spark404/STM32F070-board/ToyDevice.kicad_pcb

## KiCad design ToyDevice.kicad_pcb (2023-11-18)

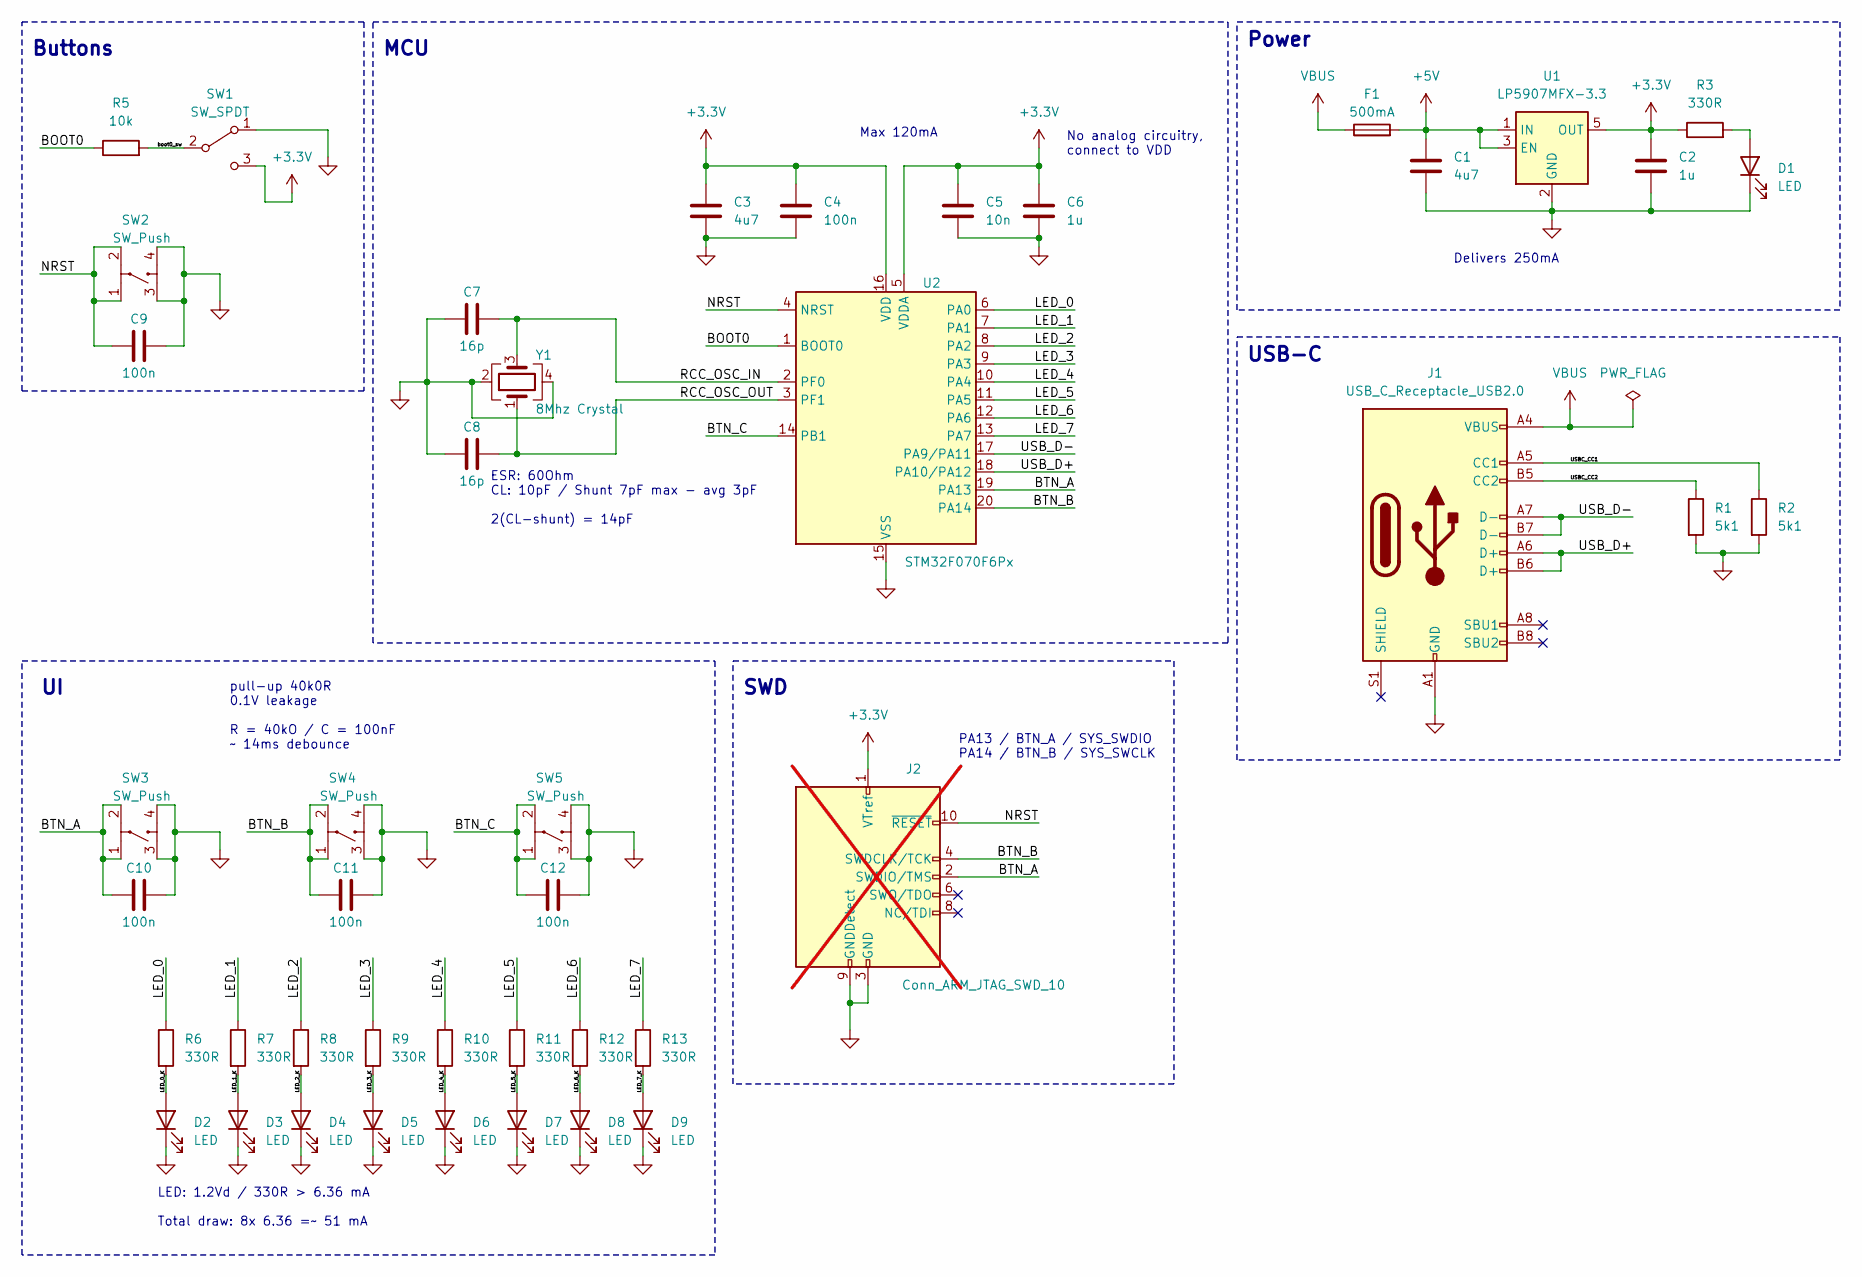
[picture p1: schematic ToyDevice.kicad_sch, Logic Test Board]

Parts:
C1, C3: 4u7; C_0402_1005Metric; Mfr Part 0402X475K6R3CT; LCSC C5173643
C2, C6: 1u; C_0402_1005Metric; Mfr Part GRM155R70J105MA12D; LCSC C913490
C4, C9, C10, C11, C12: 100n; C_0402_1005Metric; Mfr Part CL05A105KQ5NNNC; LCSC C107372
C5: 10n; C_0402_1005Metric; Mfr Part GRM1555CYA103JE01D; LCSC C1518210
C7, C8: 16p; C_0402_1005Metric; Mfr Part CC0402GRNPO9BN160; LCSC C513591
D1, D2, D3, D4, D5, D6, D7, D8, D9: LED; LED_0603_1608Metric; Mfr Part 19-213/Y2C-CQ2R2L/3T(CY); LCSC C72038
F1: 500mA; Fuse_0402_1005Metric; Mfr Part JFC0402-0500FS; LCSC C136320
J1: USB_C_Receptacle_USB2.0; SHOU-HAN-TYPE-C-16PFS-2J-H7-45-IPX8; Mfr Part TYPE-C 16PFS 2J-H7.45 IPX8; LCSC C3020050
J2: Conn_ARM_JTAG_SWD_10; PinHeader_2x05_P1.27mm_Vertical; not fitted
R1, R2: 5k1; R_0402_1005Metric; Mfr Part PTFR0402B5K11P9; LCSC C2692894
R3, R6, R7, R8, R9, R10, R11, R12, R13: 330R; R_0402_1005Metric; Mfr Part RAT023300FTH; LCSC C5139567
R5: 10k; R_0402_1005Metric; Mfr Part MCR01MZPJ103; LCSC C308028
SW1: SW_SPDT; MK-12C02-G025; Mfr Part MK-12C02-G025; LCSC C778186
SW2, SW3, SW4, SW5: SW_Push; XKB_TS_1187A_X_X_X; Mfr Part TS-1187A-B-A-B; LCSC C318884
U1: LP5907MFX-3.3; SOT-23-5; Mfr Part LP5907MFX-3.3/NOPB; LCSC C80670
U2: STM32F070F6Px; TSSOP-20_4.4x6.5mm_P0.65mm; Mfr Part STM32F070F6P6; LCSC C86951
Y1: 8Mhz Crystal; Crystal_SMD_3225-4Pin_3.2x2.5mm; Mfr Part S32080001010500; LCSC C479191

Connections:
+3.3V: C2.1, C3.1, C4.1, C5.1, C6.1, J2.1 (VTref), R3.1, SW1.3 (C), U1.5 (OUT), U2.5 (VDDA), U2.16 (VDD)
+5V: C1.1, F1.2, U1.1 (IN), U1.3 (EN)
/BOOT0: R5.1, U2.1 (BOOT0)
/BTN_A: C10.2, J2.2 (SWDIO/TMS), SW3.1, SW3.2, U2.19 (PA13)
/BTN_B: C11.2, J2.4 (SWDCLK/TCK), SW4.1, SW4.2, U2.20 (PA14)
/BTN_C: C12.2, SW5.1, SW5.2, U2.14 (PB1)
/LED_0: R6.1, U2.6 (PA0)
/LED_0_K: D2.2 (A), R6.2
/LED_1: R7.1, U2.7 (PA1)
/LED_1_K: D3.2 (A), R7.2
/LED_2: R8.1, U2.8 (PA2)
/LED_2_K: D4.2 (A), R8.2
/LED_3: R9.1, U2.9 (PA3)
/LED_3_K: D5.2 (A), R9.2
/LED_4: R10.1, U2.10 (PA4)
/LED_4_K: D6.2 (A), R10.2
/LED_5: R11.1, U2.11 (PA5)
/LED_5_K: D7.2 (A), R11.2
/LED_6: R12.1, U2.12 (PA6)
/LED_6_K: D8.2 (A), R12.2
/LED_7: R13.1, U2.13 (PA7)
/LED_7_K: D9.2 (A), R13.2
/NRST: C9.2, J2.10 (~RESET), SW2.1, SW2.2, U2.4 (NRST)
/RCC_OSC_IN: C7.2, U2.2 (PF0), Y1.3
/RCC_OSC_OUT: C8.2, U2.3 (PF1), Y1.1
/USBC_CC1: J1.A5 (CC1), R2.1
/USBC_CC2: J1.B5 (CC2), R1.1
/USB_D+: J1.A6 (D+), J1.B6 (D+), U2.18 (PA10/PA12)
/USB_D-: J1.A7 (D-), J1.B7 (D-), U2.17 (PA9/PA11)
/boot0_sw: R5.2, SW1.2 (B)
GND: C1.2, C2.2, C3.2, C4.2, C5.2, C6.2, C7.1, C8.1, C9.1, C10.1, C11.1, C12.1, D1.1 (K), D2.1 (K), D3.1 (K), D4.1 (K), D5.1 (K), D6.1 (K), D7.1 (K), D8.1 (K), D9.1 (K), J1.A1 (GND), J1.A12 (GND), J1.B1 (GND), J1.B12 (GND), J2.3 (GND), J2.5 (GND), J2.9 (GNDDetect), R1.2, R2.2, SW1.1 (A), SW2.3, SW2.4, SW3.3, SW3.4, SW4.3, SW4.4, SW5.3, SW5.4, U1.2 (GND), U2.15 (VSS), Y1.2, Y1.4
unnamed: D1.2 (A), R3.2
VBUS: F1.1, J1.A4 (VBUS), J1.A9 (VBUS), J1.B4 (VBUS), J1.B9 (VBUS)

Notes on the sheet:
MCU
PA13 / BTN_A / SYS_SWDIO PA14 / BTN_B / SYS_SWCLK
ESR: 60Ohm CL: 10pF / Shunt 7pF max - avg 3pF 2(CL-shunt) = 14pF
SWD
Power
LED: 1.2Vd / 330R > 6.36 mA Total draw: 8x 6.36 =~ 51 mA
Delivers 250mA
Buttons
No analog circuitry, connect to VDD
pull-up 40k0R 0.1V leakage R = 40kO / C = 100nF ~ 14ms debounce
USB-C
Max 120mA

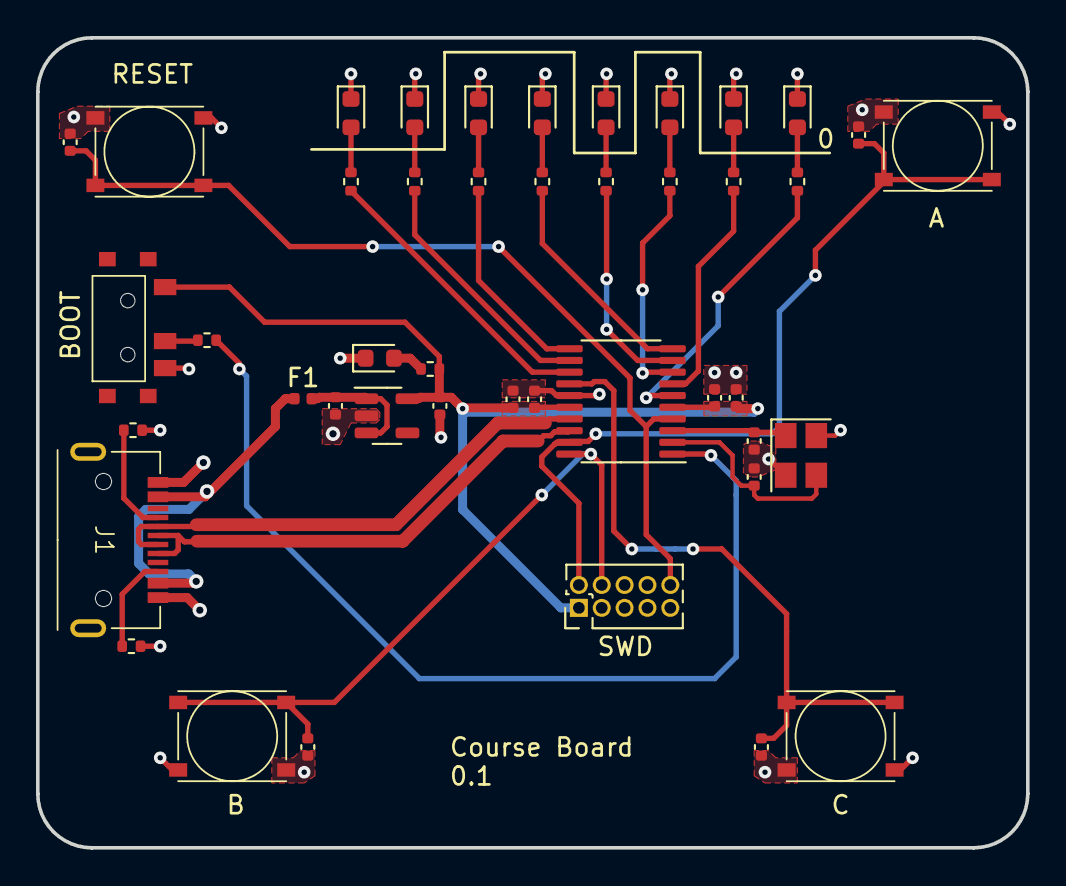
[picture p2: board ToyDevice.kicad_pcb from above]

Board: 2 copper layers, 55.0 x 45.0 mm, 44 parts (0 on the bottom side), 33 nets.
