spark404/STM32F070-board/(commit log)

2023-11-03 Course Board 0.1
    [ToyDevice.kicad_pcb, ToyDevice.kicad_sch]
2023-11-03 Add all part number
    [ToyDevice.kicad_pcb, ToyDevice.kicad_sch]
2023-11-04 Changed USB-C connector
    [ToyDevice.kicad_pcb, ToyDevice.kicad_sch]
2023-11-04 Change crystal capacitor to available type
    [ToyDevice.kicad_pcb, ToyDevice.kicad_sch]
2023-11-04 Fix missing connection RCC_OSC_OUT
    [ToyDevice.kicad_pcb]
2023-11-18 Cleanup the origin
    [ToyDevice.kicad_pcb]
